Nemes2000/IoT_turning-mill/sensor_communications/iic/iic_com.png

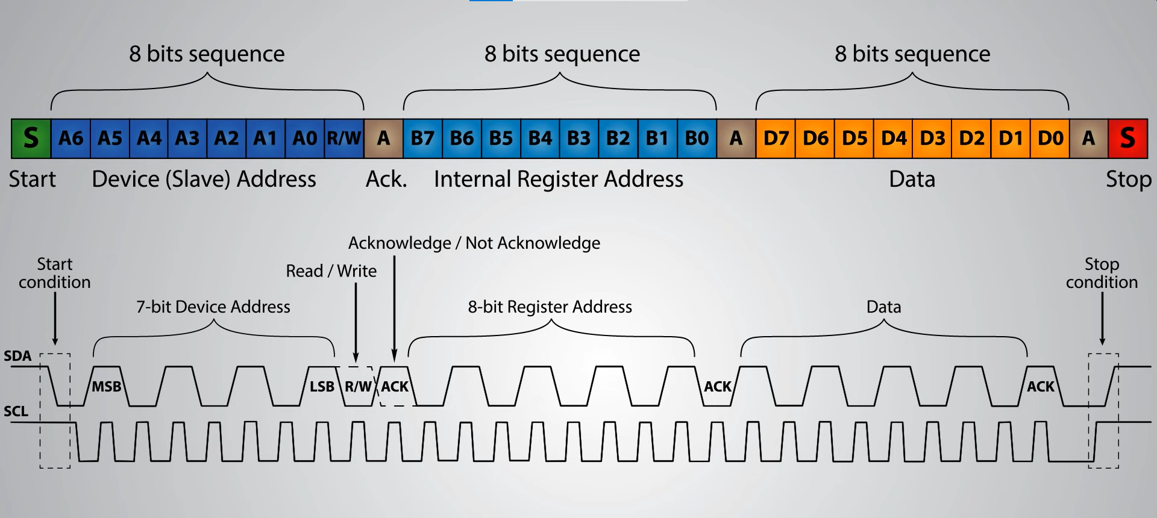
sensor_communications/iic/iic_com.png
