Nemes2000/IoT_turning-mill/sensors/esp32.png

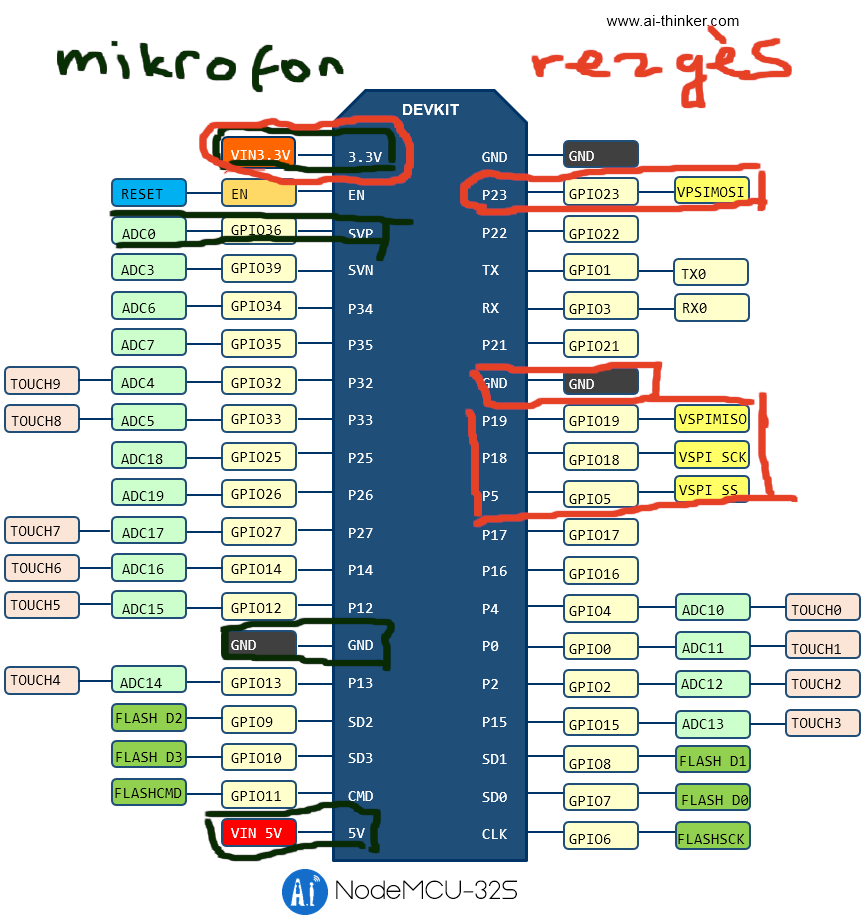
sensors/esp32.png
