Nemes2000/IoT_turning-mill/sensors/esp8266.png

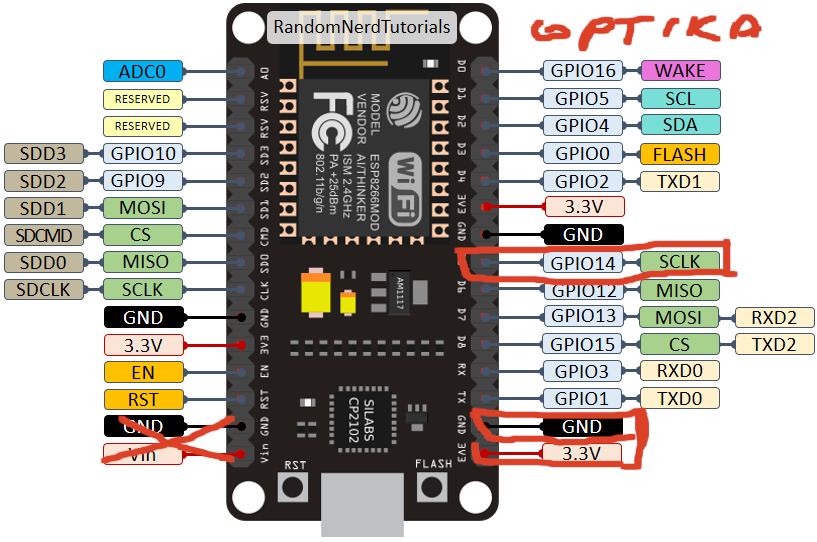
sensors/esp8266.png
